BigPanikMania/AnalogJVSy/PCB/PCB-AnalogJVSy-1.jpg

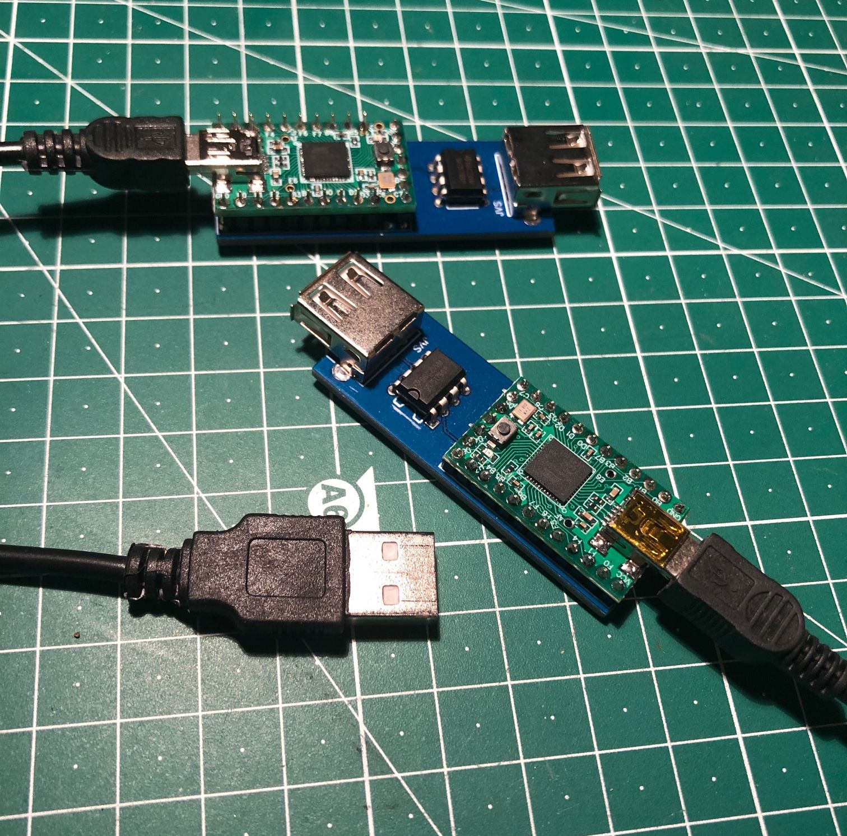
PCB/PCB-AnalogJVSy-1.jpg
