BigPanikMania/AnalogJVSy/PCB/PCB-AnalogJVSy-2.jpg

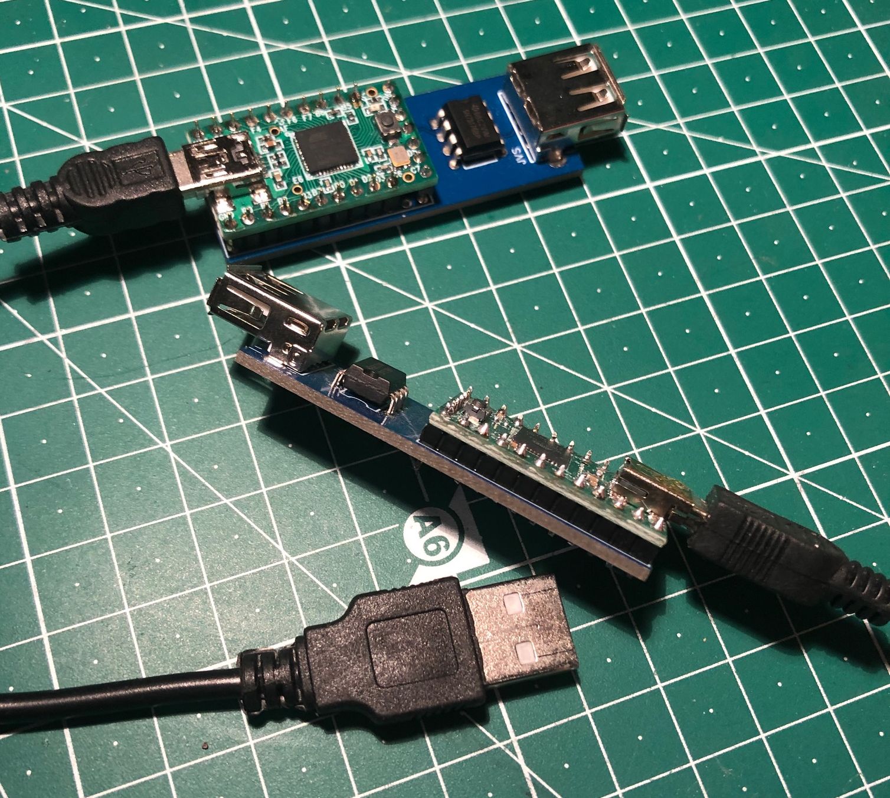
PCB/PCB-AnalogJVSy-2.jpg
