BigPanikMania/AnalogJVSy/JVS.h

/*
 * JVS.h
 *
 *  Created on: 14/apr/2014
 *      Author: k4roshi
 */

#ifndef JVS_H_
#define JVS_H_

#include "Arduino.h"
#include "Constants.h"

class JVS{
public:
	JVS(HardwareSerial& serial); // Actor
	void reset();
	void switches(int board);
  void outputs(int board, unsigned char outbyte);
	void init(int board);
	int* cmd(char destination, char data[], int size);
	bool initialized;

private:
	int coins1;
	int coins2;
	bool shift_mode;
	bool pressed_smth;
	int old_key;
	unsigned long coin_pressed_at;
	HardwareSerial& _Uart;
	void write_packet(char destination, char data[],int size);
	void assign(int attempt);
};

#endif /* JVS_H_ */
